xinnie-the-pooh/gas-de/harmful_gas_detector_v0.2/Firmware/01_harmful_gas_detector/01_harmful_gas_detector_version.txt

harmful_gas_detector软件版本更新说明：

harmful_gas_detector的设备类型为0x01, 硬件版本号为0x01.

--------------------> 版本更新说明 <--------------------
harmful_gas_detector(v00.01)-20200420.bin:

harmful_gas_detector(v00.01)-20200420.hex:

==>(v00.01)-20181119:  
编译宏: 
(1) 初始版本.
