xinnie-the-pooh/gas-de/02_电子元器件相关手册/三极管NPN和PNP.jpg

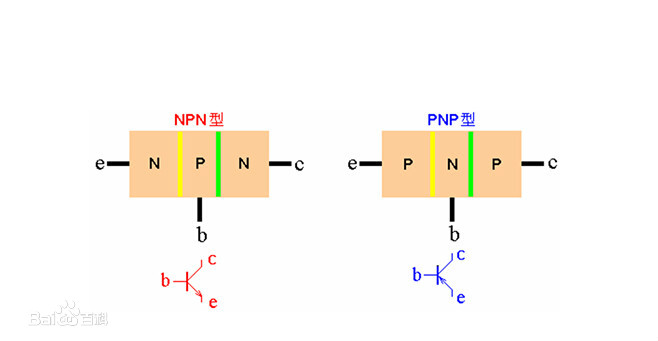
02_电子元器件相关手册/三极管NPN和PNP.jpg
