xinnie-the-pooh/gas-de/02_电子元器件相关手册/参考电路.jpg

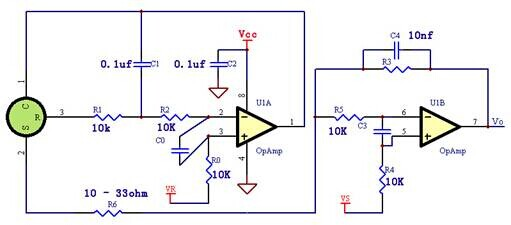
02_电子元器件相关手册/参考电路.jpg
