xinnie-the-pooh/gas-de/02_电子元器件相关手册/电化学三电极传感器标准电路图.jpg

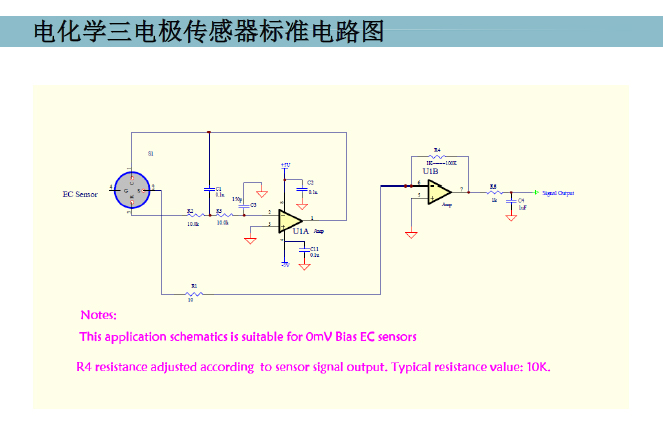
02_电子元器件相关手册/电化学三电极传感器标准电路图.jpg
