xinnie-the-pooh/gas-de/02_PCB_Layout/E22_TTL_RS232(v0.1)-20200417/E22_TTL_RS232(v0.1)-20200417.xls

Sheet: BOM Report
Bill of Materials |  |  | Bill of Materials For Project [E22_TTL_RS232(v0.1)-20200417.PrjPcb] (No PCB Document Selected)
Source Data From: |  | E22_TTL_RS232(v0.1)-20200417.PrjPcb
Project: |  | E22_TTL_RS232(v0.1)-20200417.PrjPcb
Variant: |  | None
Creation Date: | 2020-04-19 | 13:38:48
Print Date: | 43940 | 43940.56863
Footprint | Comment | #Column Name Error:LibRef | Designator | Description | Quantity
C1206-1 | 10uF/25V/5% |  | C1, C3, C7 | 钽电容 | 3
C0603 | 100nF/25V/5% |  | C2, C4, C5, C6, C8, C11, C12 | 电容 | 7
C1206-1 | 100nF/25V/5% |  | C13, C14, C15 | 钽电容 | 3
F1812 | 6V/500mA |  | F1, F2 | 自恢复保险丝 | 2
LED0603 | LED蓝灯 |  | HL1 | 发光二极管 | 1
XH2.54-LI-2P | 供电电源 |  | JP1 | XH2.54-2P/PH2.0-2P插座 | 1
PH2.0-LI-3P | RS232串口 |  | JP2 | PH2.0-3P直插插座 | 1
SK-12D07 | M0选择 |  | K1 | SK-12D07：3脚2档小型拨动开关 | 1
SK-12D07 | M1选择 |  | K2 | SK-12D07：3脚2档小型拨动开关 | 1
L0603 | 10uH/5% |  | L1, L2 | 电感 | 2
E22-400T22D | E22-400T22D |  | M1 | E22-400T22D LoRa模块 | 1
R0603 | 2K/5% |  | R1 | 电阻 | 1
R0603 | 33R/5% |  | R2, R3 | 电阻 | 2
SOT230P700X180-4N | AMS1117-3.3 |  | U1 | U_AMS1117稳压芯片 | 1
NSO16_M | MAX3232CSE |  | U2 | +5V Powered, Multi-Channel RS-232 Driver/Receiver | 1
SMA_DO-214AC | 1N5408 |  | VD1 | 开关二极管 | 1
SMA_DO-214AC | 1N4007 |  | VD2 | 开关二极管 | 1
 |  |  |  |  | 30
Approved |  | Notes

Sheet: Project Information
Project Full Path | E:\A++\wypSVN\00_goodsince_studio\06_development_projects\10_harmful_gas_detector\02_PCB_Layout\E22_TTL_RS232(v0.1)-20200417\E22_TTL_RS232(v0.1)-20200417.PrjPcb
Project Filename | E22_TTL_RS232(v0.1)-20200417.PrjPcb
Variant Name | None
Data-Source Filename | E22_TTL_RS232(v0.1)-20200417.PrjPcb
Data-Source Full Path | E:\A++\wypSVN\00_goodsince_studio\06_development_projects\10_harmful_gas_detector\02_PCB_Layout\E22_TTL_RS232(v0.1)-20200417\E22_TTL_RS232(v0.1)-20200417.PrjPcb
Title | Bill of Materials For Project [E22_TTL_RS232(v0.1)-20200417.PrjPcb] (No PCB Document Selected)
Total Quantity | 30
Report Time | 13:38:48
Report Date | 2020-04-19
Report Date & Tine | 2020-04-19 13:38:48
Output Name | Bill of Materials
Output Type | BOM_PartType
Output Generator Name | BOM
Output Generator Description | Bill of Materials
