xinnie-the-pooh/gas-de/02_PCB_Layout/HGD(v0.1)-20200419/HGD(v0.1)-20200419.xls

Sheet: BOM Report
Bill of Materials |  |  | Bill of Materials For Project [HGD(v0.1)-20200419.PrjPcb] (No PCB Document Selected)
Source Data From: |  | HGD(v0.1)-20200419.PrjPcb
Project: |  | HGD(v0.1)-20200419.PrjPcb
Variant: |  | None
Creation Date: | 2020-05-05 | 17:22:30
Print Date: | 43956 | 43956.72399
Footprint | Comment | #Column Name Error:LibRef | Designator | Description | Quantity
C0603 | 100nF/25V/5% |  | C1, C2, C3, C4, C5, C6, C7, C8, C12, C22, C24, C26, C27, C28, C30, C31, C32, C33, C34, C35, C36, C37, C38, C39 | 电容 | 24
C0603 | 20pF/25V/1% |  | C9, C10 | 电容 | 2
C1206-1 | 10uF/25V/5% |  | C21, C23, C25, C29 | 钽电容 | 4
OSC5032 | 16MHz |  | G1 | 两对电极压电晶体 | 1
LED0603 | LED蓝灯 |  | HL1, HL2 | 发光二极管 | 2
XH2.54-LI-2P | 电池接口 |  | JP1 | XH2.54-2P/PH2.0-2P插座 | 1
XH2.54-5AW | SWD |  | JP2 | XH2.54-5P直插插针 | 1
SK-12D07 | 电池开关 |  | K1 | SK-12D07：3脚2档小型拨动开关 | 1
L0603 | 10uH/5% |  | L1, L2 | 电感 | 2
E22-400T22D | E22-400T22D |  | M1 | E22-400T22D LoRa模块 | 1
JXM | JXM-O2 |  | M2 | JXM智能气体模组传感器 | 1
JXM | JXM-CO |  | M3 | JXM智能气体模组传感器 | 1
JXM | JXM-H2S |  | M4 | JXM智能气体模组传感器 | 1
JXM | JXM-LEL |  | M5 | JXM智能气体模组传感器 | 1
R0603 | 10K/5% |  | R1, R3, R5, R6, R31, R32, R33, R34, R35, R36, R37, R38, R39, R40 | 电阻 | 14
R0603 | 2K/5% |  | R2, R12, R21, R22, R23, R24 | 电阻 | 6
R0603 | 1K/5% |  | R4 | 电阻 | 1
R0603 | 1M/1% |  | R7 | 电阻 | 1
R0603 | 10M/1% |  | R19 | 电阻 | 1
R0603 | 2.2M/1% |  | R20 | 电阻 | 1
D2PAK | L7805CD2T |  | U1 | Positive voltage regulator | 1
SOT230P700X180-4N | AMS1117-3.3 |  | U2 | U_AMS1117稳压芯片 | 1
SO16_74HC4052 | 74HC4052 |  | U3 | 74HC4052 | 1
LQFP64 | STM32F105RCT6 |  | U10 | MCU | 1
SMA_DO-214AC | 1N5408 |  | VD1 | 开关二极管 | 1
SMA_DO-214AC | 1N4007 |  | VD2 | 开关二极管 | 1
LL-34 | 1N4148 |  | VD7 | 开关二极管 | 1
 |  |  |  |  | 74
Approved |  | Notes

Sheet: Project Information
Project Full Path | E:\A++\wypSVN\00_goodsince_studio\06_development_projects\10_harmful_gas_detector\02_PCB_Layout\HGD(v0.1)-20200419\HGD(v0.1)-20200419.PrjPcb
Project Filename | HGD(v0.1)-20200419.PrjPcb
Variant Name | None
Data-Source Filename | HGD(v0.1)-20200419.PrjPcb
Data-Source Full Path | E:\A++\wypSVN\00_goodsince_studio\06_development_projects\10_harmful_gas_detector\02_PCB_Layout\HGD(v0.1)-20200419\HGD(v0.1)-20200419.PrjPcb
Title | Bill of Materials For Project [HGD(v0.1)-20200419.PrjPcb] (No PCB Document Selected)
Total Quantity | 74
Report Time | 17:22:30
Report Date | 2020-05-05
Report Date & Tine | 2020-05-05 17:22:30
Output Name | Bill of Materials
Output Type | BOM_PartType
Output Generator Name | BOM
Output Generator Description | Bill of Materials
