xinnie-the-pooh/gas-de/02_PCB_Layout/HGD(v0.1)-20200419/HGD-PCB板投板申请单.xlsx

广德新衍工作室
PCB板投板申请单
投板类型： |  | □预研项目 | 时间要求： |  | □加 急 |  | 完成状态： | □模 块 □自测 |  | 申请时间：2019.08.06
 |  | □产品项目 |  |  | □普 通 |  |  | □整产品
PCB板投制需求 |  |  |  |  |  |  |  | 项目负责人：王衍平
序号 | PCB板产品名称/版本 |  |  | PCB 层数 | 板材 厚度 | PCB板尺寸 (单位:mm) |  |  | 每拼 数量 | 拼板 数量 | 实投数量 | 投板 次数 | 绘制人
1 | IIDS(v0.3)-20190806 |  |  | 2 | 1.6mm | 30.5054.128×20.828 |  |  | 1 | 5 | 5 | 1 | 王衍平
投板要求 |  | 阻焊颜色 |  |  | 字符颜色 |  |  | 外铜厚度 |  |  | 表面处理工艺
 |  | □绿色 □黄色 |  |  | □白色 |  |  | □1OZ □2OZ |  |  | □喷锡 □无铅 □化金
特殊要求
上版问题 更改汇总 |  | （1）修改PC817封装； （2）增加VD8。
投板资料 |  | □PCB 图纸 □原理图纸 □BOM清单
PCBA焊接需求
PCBA 焊接确认 |  | □内部手焊 □外协加工 □钢网新开 □载具新开
PCBA 焊接资料 |  | □物料齐套率 □焊接工艺要求 □新增物料申请单 □新增物料规格书 □新增物料采购申请单
模块/整产品需求
实验资料 |  | □测试标准 □测试方法
组装资料 |  | □软、硬件配置表 □成品辅料清单 □组装工艺指导 □产品测试指导 □包装指导
审批会签
审核问题 时间回复
 |  | 具体投出时间：2019年 月 日 |  |  |  |  |  | 计划回板时间：2019年 月 日
