xinnie-the-pooh/gas-de/02_PCB_Layout/HGD_Sensor(v0.1)-20200807/HGD_Sensor(v0.1)-20200807.pdf

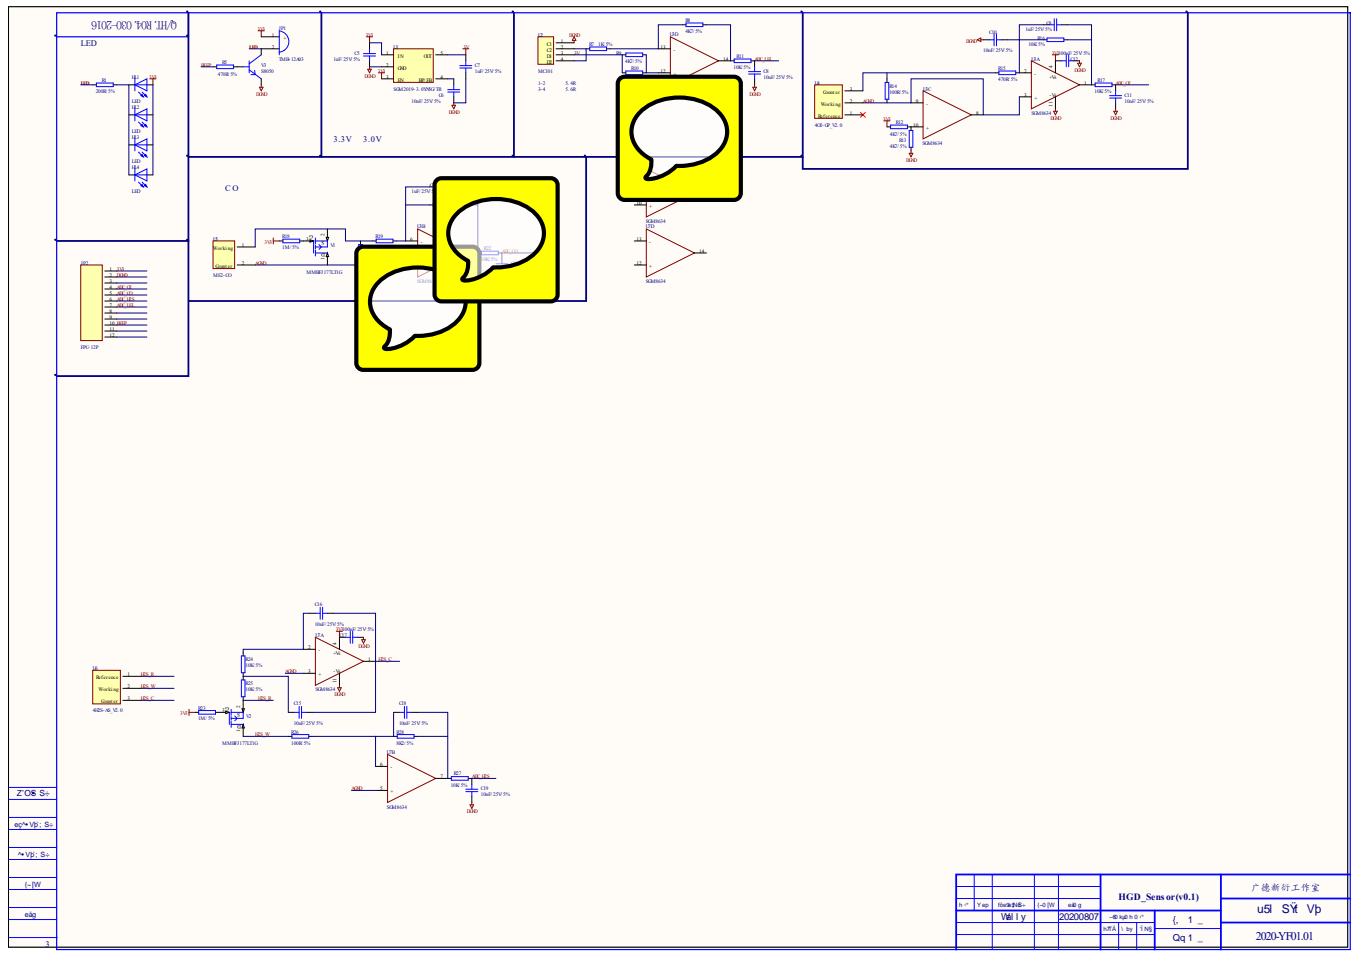
[picture p12: page 1]

LED HL1 3V3 LED | 3V3 JP1 LED + 1 - 2 BEEP 470R/ 5% V3 S8050 TMB- 12A03 R5 DGND | 3V3 IN 1 GND 2 C6 DGND 3.3V 3.0V | MC101 R10 12 + 1- 2 3- 4 5. 4R 5. 6R 4K7/ 5% SGM8634 | 10K/ 5% C8 DGND 10nF/ 25V/ 5% | C10 1uF/ 25V/ 5% C9 R16 4K7/ 5% + 4K7/ 5% DGND SGM8634 R13

eåg | 3 | h‹° Yep | fôe9e‡NöS÷ Wal l y | {~0[W eå0g 20200807 | –60kµ0h0‹° h7TÁ \ by ‘Ï N§ | Qq 1 _ | u5l SŸt Vþ {, 1 _ 2020-YF01.01

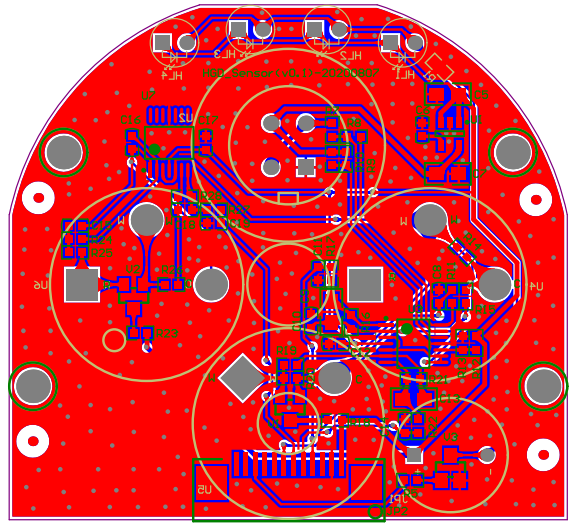
[picture p13: page 2]

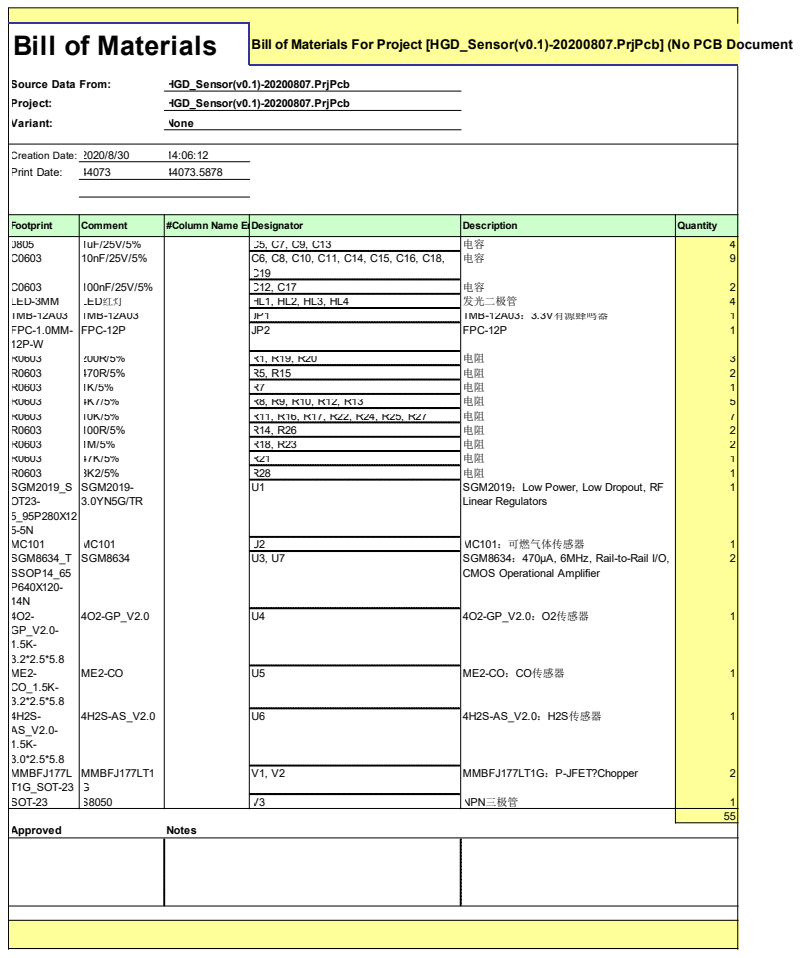
[picture p14: page 3]

Footprint | Comment | #Column Name ErDesignator | Description | Quantity

Approved Notes | 55
