xinnie-the-pooh/gas-de/(list of files, drawings)

Other design files:
02_PCB_Layout/E22_TTL_RS232(v0.1)-20200417/E22_TTL_RS232(v0.1)-20200417.PcbDoc
02_PCB_Layout/E22_TTL_RS232(v0.1)-20200417/E22_TTL_RS232(v0.1)-20200417.PrjPcb
02_PCB_Layout/E22_TTL_RS232(v0.1)-20200417/E22_TTL_RS232(v0.1)-20200417.SchDoc
02_PCB_Layout/E22_TTL_RS232(v0.2)-20200615/E22_TTL_RS232(v0.2)-20200615.PcbDoc
02_PCB_Layout/E22_TTL_RS232(v0.2)-20200615/E22_TTL_RS232(v0.2)-20200615.PrjPcb
02_PCB_Layout/E22_TTL_RS232(v0.2)-20200615/E22_TTL_RS232(v0.2)-20200615.SchDoc
02_PCB_Layout/HGD(v0.1)-20200419/HGD(v0.1)-20200419.PcbDoc
02_PCB_Layout/HGD(v0.1)-20200419/HGD(v0.1)-20200419.PrjPcb
02_PCB_Layout/HGD(v0.1)-20200419/HGD(v0.1)-20200419.SchDoc
02_PCB_Layout/HGD(v0.2)-20200615/HGD(v0.2)-20200615.PcbDoc
02_PCB_Layout/HGD(v0.2)-20200615/HGD(v0.2)-20200615.PrjPcb
02_PCB_Layout/HGD(v0.2)-20200615/HGD(v0.2)-20200615.SchDoc
02_PCB_Layout/HGD_MCU(v0.1)-20200807/HGD_MCU(v0.1)-20200807.PcbDoc
02_PCB_Layout/HGD_MCU(v0.1)-20200807/HGD_MCU(v0.1)-20200807.PrjPcb
02_PCB_Layout/HGD_MCU(v0.1)-20200807/HGD_MCU(v0.1)-20200807.SchDoc
02_PCB_Layout/HGD_MCU(v0.2)-20200901/HGD_MCU(v0.2)-20200901.PcbDoc
02_PCB_Layout/HGD_MCU(v0.2)-20200901/HGD_MCU(v0.2)-20200901.PrjPcb
02_PCB_Layout/HGD_MCU(v0.2)-20200901/HGD_MCU(v0.2)-20200901.SchDoc
02_PCB_Layout/HGD_Sensor(v0.1)-20200729-backup/HGD(v0.2)-20200615.SchDoc
02_PCB_Layout/HGD_Sensor(v0.1)-20200729-backup/HGD_Sensor(v0.1)-20200729.PcbDoc
02_PCB_Layout/HGD_Sensor(v0.1)-20200729-backup/HGD_Sensor(v0.1)-20200729.PrjPcb
02_PCB_Layout/HGD_Sensor(v0.1)-20200729-backup/HGD_Sensor(v0.1)-20200729.SchDoc
02_PCB_Layout/HGD_Sensor(v0.1)-20200729-backup/History/HGD_Sensor(v0.1)-20200729.~(44).SchDoc
02_PCB_Layout/HGD_Sensor(v0.1)-20200807/HGD_Sensor(v0.1)-20200807.PcbDoc
02_PCB_Layout/HGD_Sensor(v0.1)-20200807/HGD_Sensor(v0.1)-20200807.PrjPcb
02_PCB_Layout/HGD_Sensor(v0.1)-20200807/HGD_Sensor(v0.1)-20200807.SchDoc
02_PCB_Layout/HGD_Sensor(v0.2)-20200901/HGD_Sensor(v0.2)-20200901.PcbDoc
02_PCB_Layout/HGD_Sensor(v0.2)-20200901/HGD_Sensor(v0.2)-20200901.PrjPcb
02_PCB_Layout/HGD_Sensor(v0.2)-20200901/HGD_Sensor(v0.2)-20200901.SchDoc
02_PCB_Layout/投板文件/HGD_MCU(v0.1)-20200807/HGD_MCU(v0.1)-20200807.PcbDoc
02_PCB_Layout/投板文件/HGD_MCU(v0.2)-20200901/HGD_MCU(v0.2)-20200901.PcbDoc
02_PCB_Layout/投板文件/HGD_Sensor(v0.1)-20200807/HGD_Sensor(v0.1)-20200807.PcbDoc
02_PCB_Layout/投板文件/HGD_Sensor(v0.2)-20200901/HGD_Sensor(v0.2)-20200901.PcbDoc
气体检测泵吸式升级/硬件原理图/HGD_Update-20200515.PcbDoc
气体检测泵吸式升级/硬件原理图/HGD_Update-20200515.PcbLib
气体检测泵吸式升级/硬件原理图/HGD_Update-20200515.SchDoc
气体检测泵吸式升级/硬件原理图/HGD_Update_20200515.PrjPcb
气体检测泵吸式升级/硬件原理图/HGD_Update_20200515.SCHLIB
