xinnie-the-pooh/gas-de/04_source_code/harmful_gas_detector_v0.2/USER/gs_global_para.c

#include "gs_global_para.h"

LED_PARA ledpara;
UART_PARA debuguart;
UART_PARA lorauart;
ADC_PARA adcpara;
SYS_PARA syspara;
S_MSLEEP lora_msleep;
S_MSLEEP alarm_msleep;
JXM_DATA jxmdata[JXM_SWITCH_MAX];

void global_para_init(void)
{
}
